atisharma/Lucca-58HE/README.md

# Lucca 58HE
The Lucca 58HE is a 58 key hall effect split keyboard!

This keyboard is still very much a work in progress!! Kicad files for PCBs and switch plate, 3d files for case all available. Currently working under KMK!

---

## Fork notes (atisharma/Lucca-58HE)

This fork adds a **no-LED / no-OLED / UART** build track with order-ready
JLCPCB deliverables and cleaned-up firmware. Upstream content below is
preserved unchanged.

- `PLAN.md` -- full build plan, net-traced BOM, ordering steps.
- `PCBs/bom_lhs.csv`, `PCBs/bom_rhs.csv`, `PCBs/cpl_lhs.csv`,
  `PCBs/cpl_rhs.csv` -- JLCPCB BOM + CPL for PCBA upload (populated SMD
  only; 119 parts/side, all bottom layer).
- `PCBs/bom_net_trace.csv`, `PCBs/inventory_full.csv` -- provenance + full
  per-part classification (populated / DNP / hand-solder).
- `PCBs/assembly_README.md` -- how to place the JLC order, including the
  rotation-verification caveat.
- `firmware/calibrate.py` -- raw-ADC per-key calibration helper (prints a
  paste-ready `input_range` block for `firmware/callibration.py`).
- Firmware edits: RGB extensions removed from both `code.py`, pinout
  import fixed (`YD_RP2040` -> `waveshareRP2040zero`) in both `kb.py`.
- Restructured: firmware lives under `firmware/{left,right}/`; unused
  content removed (`boot.py`, OLED variants, `neopixel.py`, duplicate
  `quickpin/`, old test scripts, superseded `*OLD.py` files).

Key correctness note: the KiCad `Value=HX6659ISO-B` field on every Hall
sensor is a mislabel. The PCB pad assignment (1=VCC, 2=OUT, 3=GND)
matches the DRV5053 DBZ pinout; the HX6659 swaps pins 2/3 and would
short the mux input to GND. Use **DRV5053VAQDBZR** (LCSC C962159).

---



## Features

- Fully addressable per-key RGB
- 10-point RGB Underglow on each half
- Full USB-C support
- Hardware support for both SPI and UART communication between halves
- OLED screens
- Rapid Trigger
- 3D Printed Case
- Compatible with standard HE Switches, I reccomend Gateron Jades



## Bill of Materials

- Multiplexer - ADG732BSUZ 
- MCU - Waveshare RP2040 Zero 
- OLED - SSD1306 128x32 
- HE Sensor - DRV5053VAQDBZR 
- LPF Resistor 1.5k Ohm 0805 package
- I2C / SPI pull-up resistor 4.7k Ohm 0805 package
- 0 Ohm Resistors for UART mode 0805 package
- Filter caps 100nF 0805 package
- SK6803 MINI-E (you can use SK6812 instead but dont use both under glow and per key as current draw is too high)
- M2.5, 3mm brass stand offs 
- M2.5, 12mm screws with flat tops
- M2.5 x 6 x 0.4mm washers 
- M2.5 nuts 1.8mm thick
- My 3d Printed case!

## How To Install

- ...

## To do

- OLED code implementation
- implement auto calibration
- QMK port
- New HE sensor?

NEW STATUS UPDATE:

Am currently typing this update from the Lucca58HE! So its fully up and running now! There is definitely a slight latency with UART on the slave half of the keyboard. The PCB supports SPI which could potentialy have latency reductions. It might also be possible to get UART latency down too, especially once im using QMK.

OLD STATUS UPDATES:

Left half of the keyboard is now perfectly functioning under KMK! changing the actuation from from 0 to 3.5mm is possible, but some weirdness means theres a deadzone towards the end of the keystroke, it can be fixed by increasing the distance between the switch plate and PCB so not a big deal. Could probably be avoided with different HE sensors?

Working with QMK has proved a lot more difficult than i thought, so im going to get it working with KMK and circuitpython first, and then worry about QMK support after!

Hall effect sensors are currently resulting in a resolution of 0.00706mm, so things are looking very promising. My choice of HE sensor results in a voltage range of ~0 to ~0.4v, so using a different HE sensor with a greater sensitivity (not to be confused with resolution) could result in even greater resolution of distance traveled, as the 12bit ADC on the RP2040 references the internal 3.3v. Am going on family holiday soon so progress will slow down a lot, may not be able to finish the project until the new year...
