atisharma/Lucca-58HE/PCBs/bom_net_trace.csv

side | ref | value | role | pads
L | C1 | 100nF | VCC/GND decoupling | 1=VCC;2=GND
L | C101 | 100nF | sensor LPF cap A10 | 1=A10;2=GND
L | C102 | 100nF | VCC/GND decoupling | 1=GND;2=VCC
L | C11 | 100nF | sensor LPF cap A1 | 1=A1;2=GND
L | C111 | 100nF | sensor LPF cap A11 | 1=A11;2=GND
L | C112 | 100nF | VCC/GND decoupling | 1=GND;2=VCC
L | C12 | 100nF | VCC/GND decoupling | 1=GND;2=VCC
L | C121 | 100nF | sensor LPF cap A12 | 1=A12;2=GND
L | C122 | 100nF | VCC/GND decoupling | 1=GND;2=VCC
L | C131 | 100nF | sensor LPF cap A13 | 1=A13;2=GND
L | C132 | 100nF | VCC/GND decoupling | 1=GND;2=VCC
L | C141 | 100nF | sensor LPF cap A14 | 1=A14;2=GND
L | C142 | 100nF | VCC/GND decoupling | 1=GND;2=VCC
L | C151 | 100nF | sensor LPF cap A15 | 1=A15;2=GND
L | C152 | 100nF | VCC/GND decoupling | 1=GND;2=VCC
L | C161 | 100nF | sensor LPF cap A16 | 1=A16;2=GND
L | C162 | 100nF | VCC/GND decoupling | 1=GND;2=VCC
L | C171 | 100nF | sensor LPF cap A17 | 1=A17;2=GND
L | C172 | 100nF | VCC/GND decoupling | 1=GND;2=VCC
L | C181 | 100nF | sensor LPF cap A18 | 1=A18;2=GND
L | C182 | 100nF | VCC/GND decoupling | 1=GND;2=VCC
L | C191 | 100nF | sensor LPF cap A19 | 1=A19;2=GND
L | C192 | 100nF | VCC/GND decoupling | 1=GND;2=VCC
L | C2 | 100nF | VCC/GND decoupling | 1=VCC;2=GND
L | C201 | 100nF | sensor LPF cap A20 | 1=A20;2=GND
L | C202 | 100nF | VCC/GND decoupling | 1=GND;2=VCC
L | C21 | 100nF | sensor LPF cap A2 | 1=A2;2=GND
L | C211 | 100nF | sensor LPF cap A21 | 1=A21;2=GND
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
R | R3 | 1.5k | sensor LPF | 1=Q3;2=A3
R | R30 | 0R | SPI series jumper MISO(L) | 1=MISO(L);2=MISO(L)
R | R31 | 4.7k | I2C pull-up SCL | 1=SCL;2=VCC
R | R32 | 4.7k | I2C pull-up SDA | 1=SDA;2=VCC
R | R4 | 1.5k | sensor LPF | 1=Q4;2=A4
R | R5 | 1.5k | sensor LPF | 1=Q5;2=A5
R | R6 | 1.5k | sensor LPF | 1=Q6;2=A6
R | R7 | 1.5k | sensor LPF | 1=Q7;2=A7
R | R8 | 1.5k | sensor LPF | 1=Q8;2=A8
R | R9 | 1.5k | sensor LPF | 1=Q9;2=A9
