atisharma/Lucca-58HE/PCBs/inventory_full.csv

side | ref | value | footprint | lcsc | role | pop
L | C1 | 100nF | C_0805_2012Metric_Pad1.18x1.45mm_HandSolder | C1711 | decoupling | populated
L | C101 | 100nF | C_0805_2012Metric_Pad1.18x1.45mm_HandSolder | C1711 | sensor LPF cap | populated
L | C102 | 100nF | C_0805_2012Metric_Pad1.18x1.45mm_HandSolder | C1711 | decoupling | populated
L | C11 | 100nF | C_0805_2012Metric_Pad1.18x1.45mm_HandSolder | C1711 | sensor LPF cap | populated
L | C111 | 100nF | C_0805_2012Metric_Pad1.18x1.45mm_HandSolder | C1711 | sensor LPF cap | populated
L | C112 | 100nF | C_0805_2012Metric_Pad1.18x1.45mm_HandSolder | C1711 | decoupling | populated
L | C12 | 100nF | C_0805_2012Metric_Pad1.18x1.45mm_HandSolder | C1711 | decoupling | populated
L | C121 | 100nF | C_0805_2012Metric_Pad1.18x1.45mm_HandSolder | C1711 | sensor LPF cap | populated
L | C122 | 100nF | C_0805_2012Metric_Pad1.18x1.45mm_HandSolder | C1711 | decoupling | populated
L | C131 | 100nF | C_0805_2012Metric_Pad1.18x1.45mm_HandSolder | C1711 | sensor LPF cap | populated
L | C132 | 100nF | C_0805_2012Metric_Pad1.18x1.45mm_HandSolder | C1711 | decoupling | populated
L | C141 | 100nF | C_0805_2012Metric_Pad1.18x1.45mm_HandSolder | C1711 | sensor LPF cap | populated
L | C142 | 100nF | C_0805_2012Metric_Pad1.18x1.45mm_HandSolder | C1711 | decoupling | populated
L | C151 | 100nF | C_0805_2012Metric_Pad1.18x1.45mm_HandSolder | C1711 | sensor LPF cap | populated
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
R | RP2040-Zero | RP2040-Zero | RP2040-Zero Through Hole foot print (Correct version) |  | MCU module TH | manual
R | U1 | ADG732BSUZ | SU_48_ADI-M | C579103 | mux | populated
R | UG1 | SK6812MINI-E | NONFlippedUnderGlowLED |  | LED (no-LED->DNP) | DNP
R | UG10 | SK6812MINI-E | NONFlippedUnderGlowLED |  | LED (no-LED->DNP) | DNP
R | UG2 | SK6812MINI-E | NONFlippedUnderGlowLED |  | LED (no-LED->DNP) | DNP
R | UG3 | SK6812MINI-E | NONFlippedUnderGlowLED |  | LED (no-LED->DNP) | DNP
R | UG4 | SK6812MINI-E | NONFlippedUnderGlowLED |  | LED (no-LED->DNP) | DNP
R | UG5 | SK6812MINI-E | NONFlippedUnderGlowLED |  | LED (no-LED->DNP) | DNP
R | UG6 | SK6812MINI-E | NONFlippedUnderGlowLED |  | LED (no-LED->DNP) | DNP
R | UG7 | SK6812MINI-E | NONFlippedUnderGlowLED |  | LED (no-LED->DNP) | DNP
R | UG8 | SK6812MINI-E | NONFlippedUnderGlowLED |  | LED (no-LED->DNP) | DNP
R | UG9 | SK6812MINI-E | NONFlippedUnderGlowLED |  | LED (no-LED->DNP) | DNP
