atisharma/Lucca-58HE/PCBs/assembly_README.md

# Lucca 58HE -- JLCPCB assembly deliverables (no-LED, no-OLED, UART build)

Files in this directory for the **no-LED / no-OLED / UART** build:

| File | Purpose |
|---|---|
| `bom_lhs.csv`, `bom_rhs.csv` | Bill of materials for JLCPCB PCBA upload (populated SMD only) |
| `cpl_lhs.csv`, `cpl_rhs.csv` | Component placement list (X/Y/layer/rotation, populated SMD only) |
| `bom_net_trace.csv` | Per-reference provenance: the two nets each R/C bridges (from `.kicad_pcb` pad fields) |
| `inventory_full.csv` | Full per-footprint classification (populated / DNP / manual / skip) |
| `left.zip`, `right.zip`, `plate.zip` | Gerbers (bare board + switch plate) |

## What is assembled by JLC

| LCSC | Part | Qty | Role |
|---|---|-----|---|
| C962159 | DRV5053VAQDBZR Hall sensor (SOT-23 DBZ) | 29 | H1-H29 |
| C579103 | ADG732BSUZ 32:1 mux (TQFP-48) | 1 | U1 |
| C4310 | 1.5k 0805 1% resistor | 29 | R1-R29 (sensor LPF) |
| C1711 | 100nF 0805 X7R 50V cap | 60 | C1-C60 (29 LPF + 31 decoupling) |

**119 populated SMD parts per side, 238 total.**

We tried adding J1 (Molex USB-C, C5119949) and U2 (RP2040 Zero,
C5350143) as THT BOM lines on 2026-08-15; JLC flagged both as assembly
shortage (LCSC stock 0 for C5119949) and demanded substitution, so they
were removed. Hand-solder both per ../SOLDERING.md.

2026-08-15 follow-up: `bom_*_with_tht.csv` / `cpl_*_with_tht.csv` are
companion pairs with J1 (USB-C) AND U2 (RP2040 Zero) re-added as
top-layer rows. Use these -- with double-sided (bottom SMT + top THT)
placement selected -- IF you prefer to wait for both parts to return to
LCSC stock and have JLC place everything. As of 2026-08-15 both are
LCSC stock 0, so this pair blocks ordering until restock; the plain
bom/cpl pair plus hand-soldering (SOLDERING.md) is the orderable-now
path. Click the "notify me"/stock alert on the LCSC part pages
(C5119949, C5350143) to catch the restock.

## What is NOT assembled -- hand-solder or leave open

- **Through-hole (hand-solder):** 1x Waveshare RP2040 Zero, 1x Molex 2137160001
  USB-C. (OLED 4-pin header is no-OLED -> do not fit.)
- **DNP -- do not populate:**
  - 39x SK6812MINI-E LEDs per side (29 per-key + 10 underglow) -- no-LED build.
  - I2C pull-ups: LHS R32/R33, RHS R31/R32 (4.7k) -- no OLED, no I2C traffic.
  - CS pull-up: LHS R30 (4.7k) -- no SPI peripheral on the no-peripheral build.
  - SPI-series 0R: LHS R31/R34/R35, RHS R30 -- firmware uses UART, not SPI.
  - RHS solder jumpers (3x) -- leave OPEN for UART.
  - OLED 4-pin pin header.

## Single-side Standard assembly (Economic not available)

All 119 populated SMD parts per side are on the **BOTTOM** layer (B.Cu). The only
top-side parts are through-hole (RP2040 Zero, USB-C, OLED header) or DNP
resistors. So single-side placement covers everything -- no
double-side assembly fee required. JLC's cheaper Economic PCBA tier drops
out for this order because ENIG (and castellated-hole styles) are
Economic-restricted -- select **Standard** PCBA and the **bottom** side
only. Decline the optional conformal coating (Standard-tier add-on): it
adds cost/lead time, does nothing for a desk keyboard, and interferes
with the later hand-soldering and any rework.

Set assembly **quantity = 2 per side** (JLC minimum, both tiers). The
default 5+5 quotes ~$228/side in components (mux is ~$28.71 and the
DRV5053 has tripled to ~$0.39 each, as of 2026-08-15); qty 2+2 lands
components at ~$163 total and keeps sensor demand inside LCSC's ~230
stock.

## CRITICAL -- rotation must be verified in JLC's upload preview

The rotation values in `cpl_*.csv` are emitted directly by KiCad's
`kicad-cli pcb export pos`. They are the **mechanical baseline** but are NOT
guaranteed to match JLC's library part orientations:

1. JLC matches each placement to its LCSC part and applies JLC's OWN library
   rotation. KiCad and JLC footprint frames do not always agree, especially for
   the ADG732 (TQFP-48, pin-1 location) and the SOT-23 sensors.
2. For bottom-side parts there is an additional mirror convention; the raw
   KiCad rotation may need a per-footprint offset (commonly +180 degrees for
   some footprints).

**Before confirming the order**, step through JLC's online BOM/CPL preview and
visually confirm the pin-1 / orientation overlay for at least:
- the ADG732 mux (U1) -- pin 1 toward the correct corner (procedure below),
- the DRV5053 sensors -- VCC on pad 1, OUT on pad 2, GND on pad 3 (see
  PLAN.md "Sensor choice" -- the board is wired for the DRV5053 DBZ pinout; an
  HX6659 will NOT work),
- a few 0805 passives (rotation is less critical for symmetric pads).

### Concrete pin-1 procedure for U1 (extracted from the kicad_pcb files)

Facts: U1 sits on B.Cu both halves, diagonal. LHS board pos
(188.01, 90.51), rot -45 deg (CPL value 315); RHS (346.98, -6.18),
rot +45 deg (CPL value 45). In the footprint's own frame, pin 1 is the
bottom pad of the LEFT column (pads 1-12 left column, 13-24 top,
25-36 right, 37-48 bottom). LHS pin-1 net = A7; RHS = A22.

1. KiCad anchor: open the project (`PCBs/Lucca1.0.kicad_pcbLHS.kicad_pro`
   in the KiCad 8 project manager; the bare .kicad_pcb needs its
   .kicad_pro stub to open in the GUI), Alt+3 (3D viewer), orbit to the
   bottom face, find U1, note which physical corner of the board its
   pin-1 chamfer points to (use a landmark, e.g. the USB-C edge).
2. JLC anchor: in the upload preview, click U1; the part graphic's
   pin-1 dot/chamfer must point to the SAME physical corner.
3. Numbers are NOT the arbiter: JLC may show a rotation different from
   our CPL values (their library footprint zero-frame differs from the
   custom SU_48_ADI-M). Different number + correct corner = fine. Wrong
   corner = fix.
4. Fixes can be done per-part directly in JLC's placement table (they
   allow rotation edits at the preview stage) instead of re-uploading
   the CPL. If you do fix it there, note the corrected value and update
   cpl_lhs.csv / cpl_rhs.csv to match for the next order.

### Verification log

- 2026-08-15: U1 orientation verified in JLC's 3D preview, both halves --
  the preview pin-1 dot aligned with the board's silkscreen pin-1 marker.
  DRV5053 SOT-23 sensor orientation NOT yet verified in the preview --
  spot-check 2-3 (incl. H25/H26 1.5U) before paying.

## How these files were generated (reproducible)

- `bom_net_trace.csv` and `inventory_full.csv`: parsed each footprint block in
  `Lucca1.0.kicad_pcbLHS.kicad_pcb` and `...RHS...`, extracted the
  `(property "Reference"/"Value")` and each pad's `(net N "name")`, and
  classified resistors/caps by which two nets they bridge. No schematic was
  needed -- KiCad 8 stores pad net assignments in the PCB.
- `cpl_*.csv`: `kicad-cli pcb export pos --units mm --side both` (KiCad 10),
  filtered to the 119 populated-SMD references per side, Layer mapped
  bottom->B.
- All passive LCSC numbers were verified against the JLC part-detail pages
  (C4310, C17673, C17477, C1711 -- all "Economic and Standard", in stock).

## Known limitation of inventory_full.csv

The reference `REF**` is shared by 16 footprints per side (15 mounting holes +
1 USB-C connector), so the CSV collapses them to a single row. This does not
affect `bom_*.csv` / `cpl_*.csv`, which key on the unique R/C/H/U1 references.
