atisharma/Lucca-58HE/(commit log)

2026-08-15 docs: build plan and JLCPCB assembly deliverables (no-LED build)
    [bom_lhs.csv, bom_net_trace.csv, bom_rhs.csv, inventory_full.csv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]
2026-08-15 firmware: remove RGB extensions, fix waveshare pinout import, add calibration helper
    [analogio.py, calibrate.py, code.py, kb.py]
2026-08-15 cleanup: consolidate firmware/ layout, remove unused content
    - firmware/{left,right}/ replaces 'LEFT KB AND CODE'/'RIGHT KB AND CODE';
    shared analogio.py, callibration.py, calibrate.py under firmware/
    - deleted: boot.py (GP7/MulControl4 conflict footgun), OLED variant +
    display assets (no-OLED build), neopixel.py, duplicate quickpin/
    (identical copy inside kmk_firmware-main/kmk/quickpin/), 'Test for
    lucca!' sweep scripts (superseded by calibrate.py), *OLD.py upstream
    leftovers
    - docs updated throughout for new paths
    [analogio.py, calibrate.py, code.py, kb.py]
2026-08-15 docs: ENIG finish decision + JLC3DP bundled case (no local printer)
2026-08-15 docs: white solder mask chosen; record no-high-spec-options decision
2026-08-15 fix: BOMs CRLF->LF (JLC 'BOM doesn't match CPL' parse failure); docs: Standard PCBA (Economic rejects 4-layer), decline conformal coating
    [bom_lhs.csv, bom_rhs.csv]
2026-08-15 fix: expand BOMs to one reference per row (JLC BOM/CPL match check)
    [bom_lhs.csv, bom_rhs.csv]
2026-08-15 docs: concrete U1 pin-1 verification procedure for JLC preview
2026-08-15 docs+infra: kicad_pro stubs so boards open in KiCad GUI; log U1 pin-1 verified in JLC preview
2026-08-15 docs: live part prices (mux ~$28.7, DRV5053 ~$0.39), assembly qty 2/side, Economic unavailable due to ENIG, BOMs now one-ref-per-row
2026-08-15 bom: add J1 USB-C (C5119949) + U2 RP2040 Zero (C5350143) as JLC THT lines
    [bom_lhs.csv, bom_rhs.csv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]
2026-08-15 revert: drop J1/U2 THT rows (JLC reports assembly shortage on both); hand-solder per SOLDERING.md
    [bom_lhs.csv, bom_rhs.csv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]
2026-08-15 bom: companion *_with_usbc pairs (J1 only) for JLC Parts Sourcing path; LCSC C5119949 stock confirmed 0
    [bom_lhs_with_usbc.csv, bom_rhs_with_usbc.csv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]
2026-08-15 bom: *_with_tht companion pairs (J1+U2) for wait-for-restock route; both LCSC stock 0 as of today
    [bom_lhs_with_tht.csv, bom_rhs_with_tht.csv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]
